hcgernhardtiii/kb-usb-to-coco/kb-usb-to-coco-pcb/kb-usb-to-coco.kicad_pcb

## KiCad design kb-usb-to-coco-pcb/kb-usb-to-coco.kicad_pcb (2025-03-23)

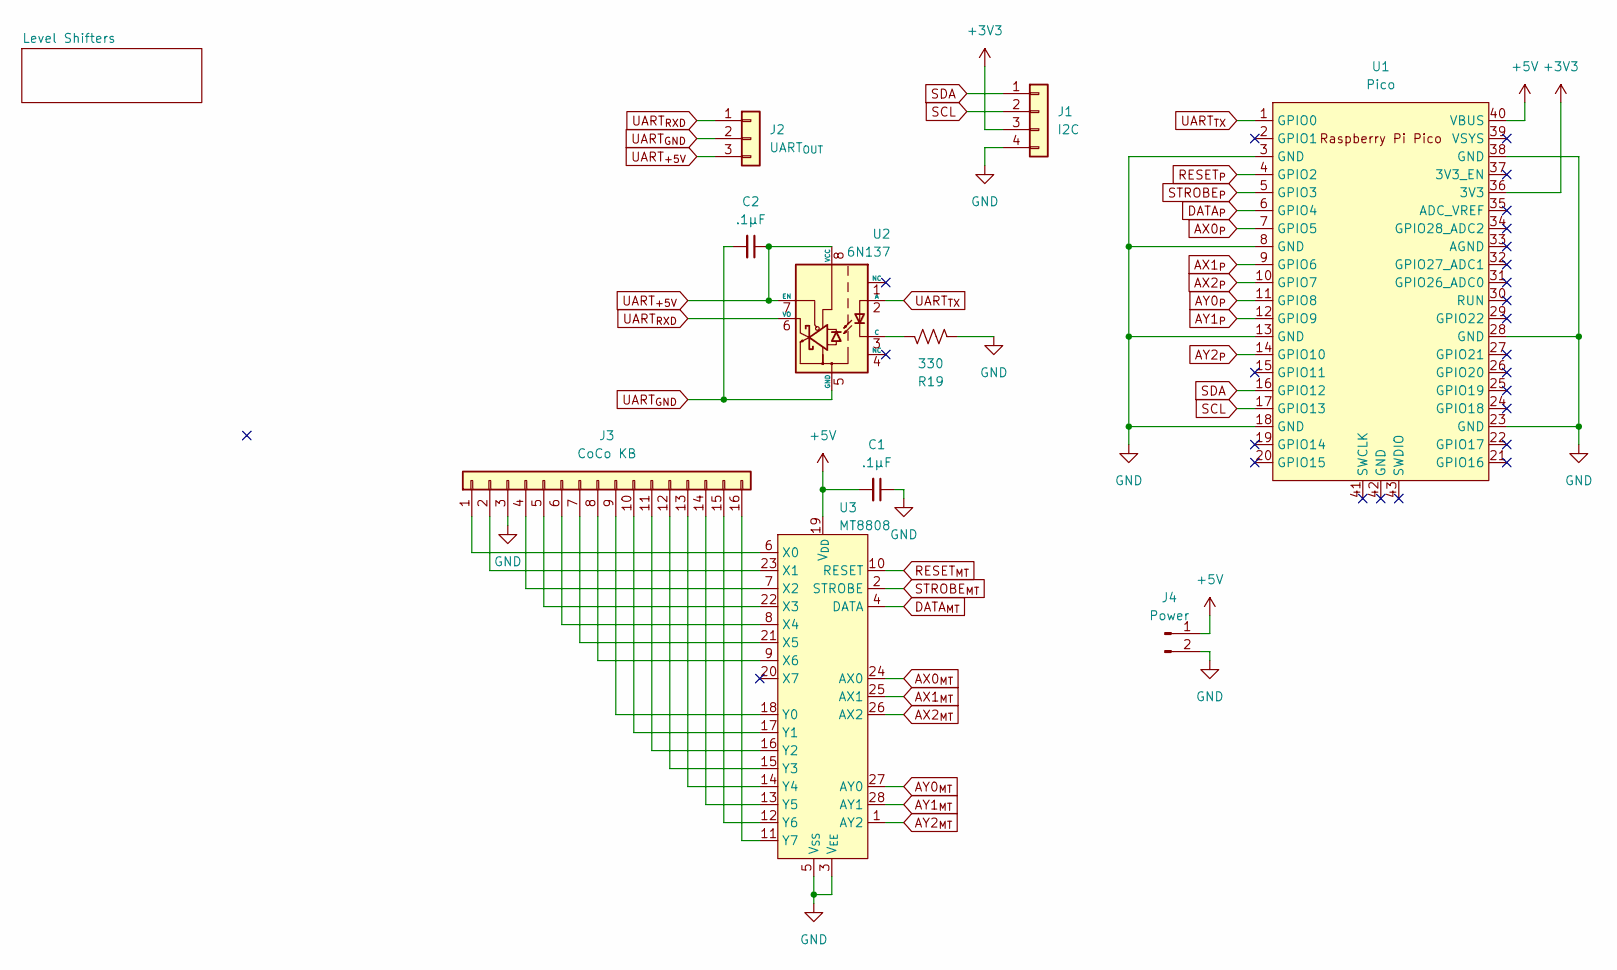
[picture p1: schematic kb-usb-to-coco.kicad_sch]

Parts:
C1, C2: .1µF; C_Disc_D6.0mm_W2.5mm_P5.00mm
J1: I2C; PinHeader_1x04_P2.54mm_Vertical
J2: UART_{OUT}; PinHeader_1x03_P2.54mm_Vertical
J3: CoCo KB; PinHeader_1x16_P2.54mm_Vertical
J4: Power; PinHeader_1x02_P2.54mm_Vertical
R19: 330; R_Axial_DIN0207_L6.3mm_D2.5mm_P7.62mm_Horizontal
U1: Pico; RPi_Pico_SMD_TH
U2: 6N137; DIP-8_W7.62mm_Socket_LongPads
U3: MT8808; DIP-28_W15.24mm_Socket_LongPads

Connections:
+3V3: J1.3, U1.36 (3V3); also elsewhere on the board
+5V: C1.2, J4.1, U1.40 (VBUS), U3.19 (V_{DD}); also elsewhere on the board
AX0_{MT}: U3.24 (AX0); also elsewhere on the board
AX0_{P}: U1.7 (GPIO5); also elsewhere on the board
AX1_{MT}: U3.25 (AX1); also elsewhere on the board
AX1_{P}: U1.9 (GPIO6); also elsewhere on the board
AX2_{MT}: U3.26 (AX2); also elsewhere on the board
AX2_{P}: U1.10 (GPIO7); also elsewhere on the board
AY0_{MT}: U3.27 (AY0); also elsewhere on the board
AY0_{P}: U1.11 (GPIO8); also elsewhere on the board
AY1_{MT}: U3.28 (AY1); also elsewhere on the board
AY1_{P}: U1.12 (GPIO9); also elsewhere on the board
AY2_{MT}: U3.1 (AY2); also elsewhere on the board
AY2_{P}: U1.14 (GPIO10); also elsewhere on the board
DATA_{MT}: U3.4 (DATA); also elsewhere on the board
DATA_{P}: U1.6 (GPIO4); also elsewhere on the board
GND: C1.1, J1.4, J3.3, J4.2, R19.1, U1.3 (GND), U1.8 (GND), U1.13 (GND), U1.18 (GND), U1.23 (GND), U1.28 (GND), U1.38 (GND), U3.3 (V_{EE}), U3.5 (V_{SS})
unnamed: J3.1, U3.6 (X0)
unnamed: J3.2, U3.23 (X1)
unnamed: J3.4, U3.7 (X2)
unnamed: J3.5, U3.22 (X3)
unnamed: J3.6, U3.8 (X4)
unnamed: J3.7, U3.21 (X5)
unnamed: J3.8, U3.9 (X6)
unnamed: J3.9, U3.18 (Y0)
unnamed: J3.10, U3.17 (Y1)
unnamed: J3.11, U3.16 (Y2)
unnamed: J3.12, U3.15 (Y3)
unnamed: J3.13, U3.14 (Y4)
unnamed: J3.14, U3.13 (Y5)
unnamed: J3.15, U3.12 (Y6)
unnamed: J3.16, U3.11 (Y7)
unnamed: R19.2, U2.3 (C)
RESET_{MT}: U3.10 (RESET); also elsewhere on the board
RESET_{P}: U1.4 (GPIO2); also elsewhere on the board
SCL: J1.2, U1.17 (GPIO13)
SDA: J1.1, U1.16 (GPIO12)
STROBE_{MT}: U3.2 (STROBE); also elsewhere on the board
STROBE_{P}: U1.5 (GPIO3); also elsewhere on the board
UART_{+5V}: C2.1, J2.3, U2.7 (EN), U2.8 (VCC)
UART_{GND}: C2.2, J2.2, U2.5 (GND)
UART_{RXD}: J2.1, U2.6 (VO)
UART_{TX}: U1.1 (GPIO0), U2.2 (A)

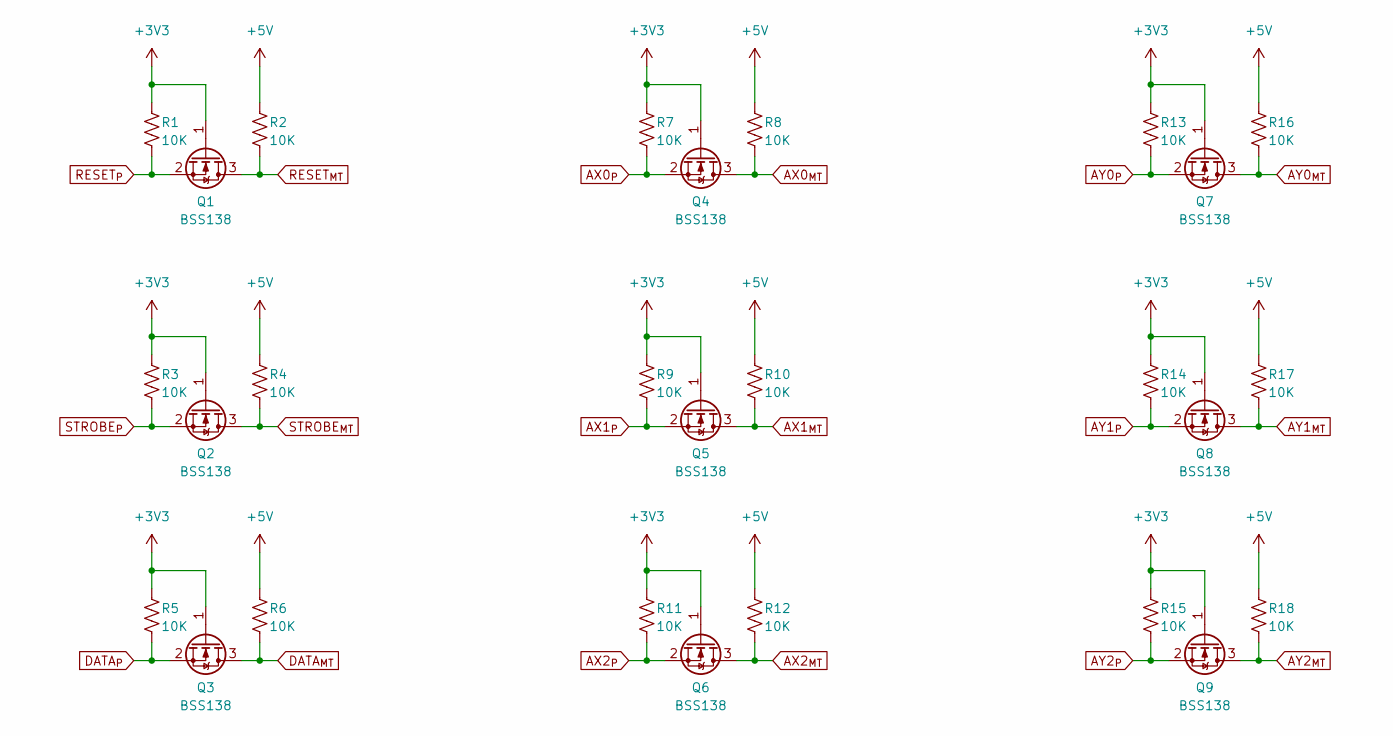
[picture p2: schematic untitled.kicad_sch]

Parts:
Q1, Q2, Q3, Q4, Q5, Q6, Q7, Q8, Q9: BSS138; SOT-23
R1, R2, R3, R4, R5, R6, R7, R8, R9, R10, R11, R12, R13, R14, R15, R16, R17, R18: 10K; R_0603_1608Metric

Connections:
+3V3: Q1.1 (G), Q2.1 (G), Q3.1 (G), Q4.1 (G), Q5.1 (G), Q6.1 (G), Q7.1 (G), Q8.1 (G), Q9.1 (G), R1.1, R3.1, R5.1, R7.1, R9.1, R11.1, R13.1, R14.1, R15.1; also elsewhere on the board
+5V: R2.1, R4.1, R6.1, R8.1, R10.1, R12.1, R16.1, R17.1, R18.1; also elsewhere on the board
AX0_{MT}: Q4.3 (D), R8.2; also elsewhere on the board
AX0_{P}: Q4.2 (S), R7.2; also elsewhere on the board
AX1_{MT}: Q5.3 (D), R10.2; also elsewhere on the board
AX1_{P}: Q5.2 (S), R9.2; also elsewhere on the board
AX2_{MT}: Q6.3 (D), R12.2; also elsewhere on the board
AX2_{P}: Q6.2 (S), R11.2; also elsewhere on the board
AY0_{MT}: Q7.3 (D), R16.2; also elsewhere on the board
AY0_{P}: Q7.2 (S), R13.2; also elsewhere on the board
AY1_{MT}: Q8.3 (D), R17.2; also elsewhere on the board
AY1_{P}: Q8.2 (S), R14.2; also elsewhere on the board
AY2_{MT}: Q9.3 (D), R18.2; also elsewhere on the board
AY2_{P}: Q9.2 (S), R15.2; also elsewhere on the board
DATA_{MT}: Q3.3 (D), R6.2; also elsewhere on the board
DATA_{P}: Q3.2 (S), R5.2; also elsewhere on the board
RESET_{MT}: Q1.3 (D), R2.2; also elsewhere on the board
RESET_{P}: Q1.2 (S), R1.2; also elsewhere on the board
STROBE_{MT}: Q2.3 (D), R4.2; also elsewhere on the board
STROBE_{P}: Q2.2 (S), R3.2; also elsewhere on the board

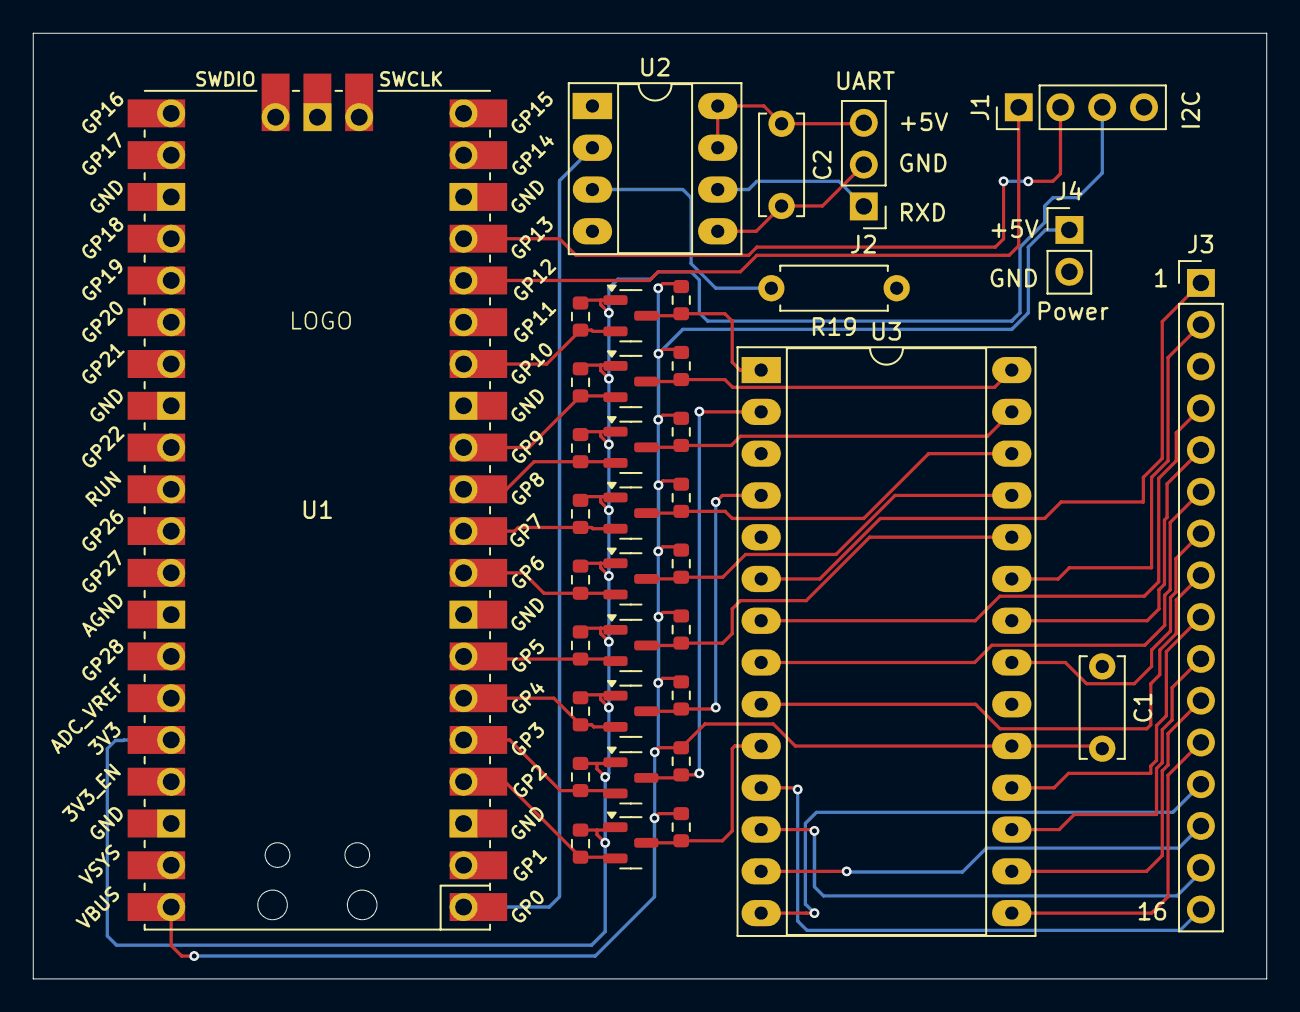
[picture p3: board kb-usb-to-coco.kicad_pcb from above]

Board: 2 copper layers, 75.0 x 57.5 mm, 38 parts (0 on the bottom side), 43 nets.

Other parts of the board:
LOGO: tbk-logo
