hcgernhardtiii/kb-usb-to-coco/kb-flat-jumper/kb-flat-jumper.kicad_pcb

## KiCad design kb-flat-jumper/kb-flat-jumper.kicad_pcb (2025-03-23)

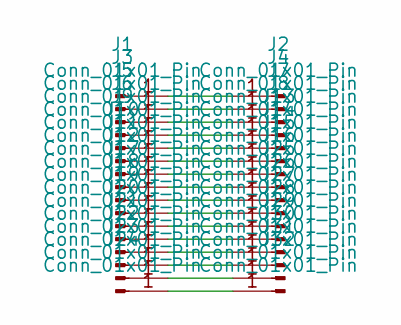
[picture p4: schematic kb-flat-jumper.kicad_sch]

Parts:
J1, J2, J3, J4, J5, J6, J7, J8, J9, J10, J11, J12, J13, J14, J15, J16, J17, J18, J19, J20, J21, J22, J23, J24, J25, J26, J27, J28, J29, J30, J31, J32: Conn_01x01_Pin; pad_1.27mm_5.588mm

Connections:
unnamed: J1.1, J2.1
unnamed: J3.1, J4.1
unnamed: J5.1, J7.1
unnamed: J6.1, J8.1
unnamed: J10.1, J14.1
unnamed: J11.1, J15.1
unnamed: J12.1, J16.1
unnamed: J9.1, J13.1
unnamed: J17.1, J25.1
unnamed: J18.1, J26.1
unnamed: J19.1, J27.1
unnamed: J20.1, J28.1
unnamed: J21.1, J29.1
unnamed: J22.1, J30.1
unnamed: J23.1, J31.1
unnamed: J24.1, J32.1

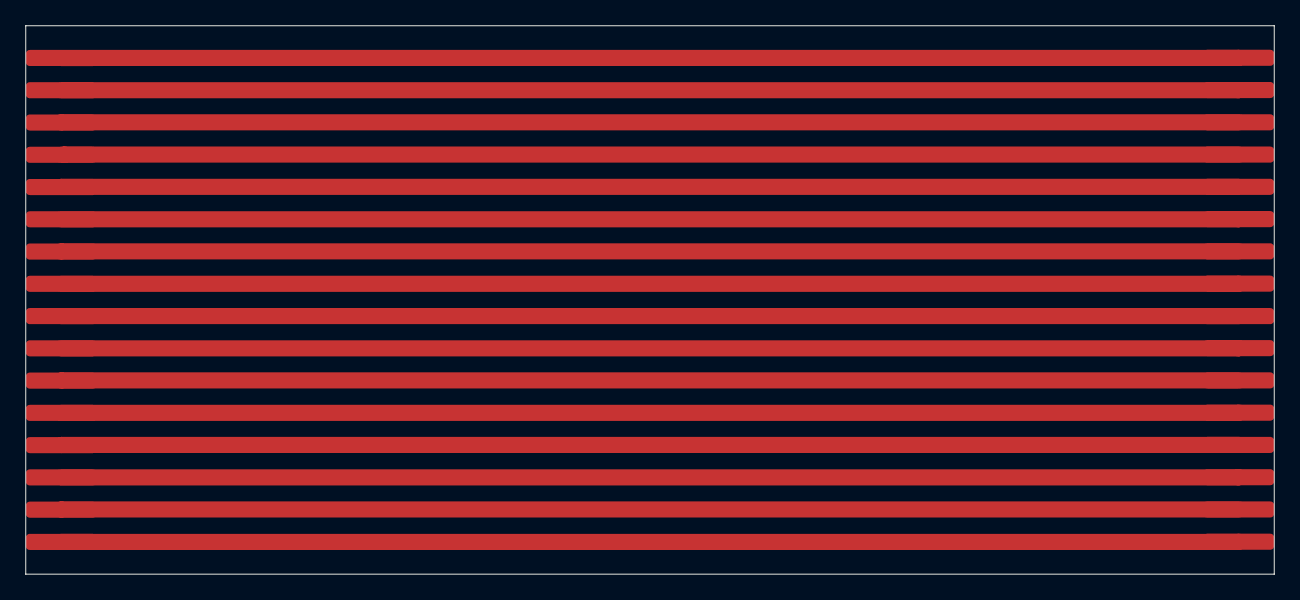
[picture p5: board kb-flat-jumper.kicad_pcb from above]

Board: 2 copper layers, 98.3 x 43.2 mm, 32 parts (0 on the bottom side), 16 nets.
