hcgernhardtiii/kb-usb-to-coco/kb-usb-to-coco-firmware/mapped_matrix.h

#ifndef ___MAPPED_MATRIX_H
#define ___MAPPED_MATRIX_H

uint8_t ecb_map[256][8][4] = {{
	{0100,0100,0100,0100},{0100,0100,0100,0100},
	{0100,0100,0100,0100},{0100,0100,0100,0100},
	{0100,0100,0100,0100},{0100,0100,0100,0100},
	{0100,0100,0100,0100},{0100,0100,0100,0100}
}, {
	{0100,0100,0100,0100},{0100,0100,0100,0100},
	{0100,0100,0100,0100},{0100,0100,0100,0100},
	{0100,0100,0100,0100},{0100,0100,0100,0100},
	{0100,0100,0100,0100},{0100,0100,0100,0100}
}, {
	{0100,0100,0100,0100},{0100,0100,0100,0100},
	{0100,0100,0100,0100},{0100,0100,0100,0100},
	{0100,0100,0100,0100},{0100,0100,0100,0100},
	{0100,0100,0100,0100},{0100,0100,0100,0100}
}, {
	{0100,0100,0100,0100},{0100,0100,0100,0100},
	{0100,0100,0100,0100},{0100,0100,0100,0100},
	{0100,0100,0100,0100},{0100,0100,0100,0100},
	{0100,0100,0100,0100},{0100,0100,0100,0100}
}, {
	{0001,0100,0100,0100},{0064,0001,0100,0100},
	{0067,0001,0100,0100},{0064,0067,0001,0100},
	{0063,0001,0100,0100},{0064,0063,0001,0100},
	{0067,0063,0001,0100},{0064,0067,0063,0001}
}, {
	{0002,0100,0100,0100},{0064,0002,0100,0100},
	{0067,0002,0100,0100},{0064,0067,0002,0100},
	{0063,0002,0100,0100},{0064,0063,0002,0100},
	{0067,0063,0002,0100},{0064,0067,0063,0002}
}, {
	{0003,0100,0100,0100},{0064,0003,0100,0100},
	{0067,0003,0100,0100},{0064,0067,0003,0100},
	{0063,0003,0100,0100},{0064,0063,0003,0100},
	{0067,0063,0003,0100},{0064,0067,0063,0003}
}, {
	{0004,0100,0100,0100},{0064,0004,0100,0100},
	{0067,0004,0100,0100},{0064,0067,0004,0100},
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
	{0100,0100,0100,0100},{0100,0100,0100,0100},
	{0100,0100,0100,0100},{0100,0100,0100,0100},
	{0100,0100,0100,0100},{0100,0100,0100,0100}
}, {
	{0100,0100,0100,0100},{0100,0100,0100,0100},
	{0100,0100,0100,0100},{0100,0100,0100,0100},
	{0100,0100,0100,0100},{0100,0100,0100,0100},
	{0100,0100,0100,0100},{0100,0100,0100,0100}
}, {
	{0100,0100,0100,0100},{0100,0100,0100,0100},
	{0100,0100,0100,0100},{0100,0100,0100,0100},
	{0100,0100,0100,0100},{0100,0100,0100,0100},
	{0100,0100,0100,0100},{0100,0100,0100,0100}
}, {
	{0100,0100,0100,0100},{0100,0100,0100,0100},
	{0100,0100,0100,0100},{0100,0100,0100,0100},
	{0100,0100,0100,0100},{0100,0100,0100,0100},
	{0100,0100,0100,0100},{0100,0100,0100,0100}
}, {
	{0100,0100,0100,0100},{0100,0100,0100,0100},
	{0100,0100,0100,0100},{0100,0100,0100,0100},
	{0100,0100,0100,0100},{0100,0100,0100,0100},
	{0100,0100,0100,0100},{0100,0100,0100,0100}
}, {
	{0100,0100,0100,0100},{0100,0100,0100,0100},
	{0100,0100,0100,0100},{0100,0100,0100,0100},
	{0100,0100,0100,0100},{0100,0100,0100,0100},
	{0100,0100,0100,0100},{0100,0100,0100,0100}
}};

#endif
