hcgernhardtiii/kb-usb-to-coco/kb-usb-to-coco-firmware/kb-usb-to-coco-firmware.h

#ifndef ___KB_USB_TO_COCO_FIRMWARE_H
#define ___KB_USB_TO_COCO_FIRMWARE_H

#include <stdio.h>
#include "time.h"
#include "pico/stdlib.h"
#include "hardware/gpio.h"
#include "bsp/board_api.h"
#include "tusb.h"
#include "mt8808.h"
#include "raw_matrix.h"
#include "mapped_matrix.h"
#include "ssd1306_i2c.h"
#include "sprite.h"

#define MAX_REPORT 4

static struct {
	uint8_t report_count;
	tuh_hid_report_info_t report_info[MAX_REPORT];
} hid_info[CFG_TUH_HID];

static uint8_t blank_screen[128*8];
static struct render_area blank_screen_area = {
	.start_col = 0,
	.end_col = 127,
	.start_page = 0,
	.end_page = 7,
	.buflen = 128 * 8
};

static bool screen_is_dirty = false;

// Some mode flags we'll need:
// - <kbd>GUI</kbd> is our special function key.  If it's pressed we're talking
//   to the interface, not to the CoCo.
static bool gui_is_pressed = false;
// - Whether or not we're in mapped mode (we start in raw mode)
static bool mapped_mode_active = false;
// - Whether or not we're recording a macro (macro keys will be dealt with in
//   `process_kbd_report()`)
static bool recording_macro = false;

// Whether or not a keycode exists within a given matrix
#define MATRIX_HAS(mtx, key) ( \
	!!(((mtx)[((key) & 0xf0) >> 4]) & (1 << ((key) & 0x0f))) \
)

void led_blinking_task (void);
static void process_kbd_report(hid_keyboard_report_t const *report);
static void cls();
static void putblock (int row, int col);
static void clrblock (int row, int col);
static inline void mt8808_send (int row, int col, int data);
static inline void macro_record_send (int row, int col, int data) {}
static inline void mt8808_pause();
static inline void macro_record_pause() {}

// process the matrix in raw mode
static void raw_mode (hid_keyboard_report_t const *report);
// process the matrix in mapped mode
static void mapped_mode (
	hid_keyboard_report_t const *report,
	uint16_t presses[16]
);

// Visualize the “big” matrix—the raw keyboard scan itself
static void visualize_bigm (
	uint16_t cur[16],
	uint16_t presses[16],
	uint16_t releases[16]
);

#endif
