hcgernhardtiii/kb-usb-to-coco/kb-usb-to-coco-firmware/sprite.h

#include "ssd1306_i2c.h"

// two-quote and at sign are 35+6+12
struct render_area two_quote_area = {
	.start_col = (127 - (35 + 6 + 12)) / 2,
	.end_col = ((127 - (35 + 6 + 12)) / 2) + 11,
	.start_page = 2,
	.end_page = 7,
	.buflen = 12 * 6
};
uint8_t two_quote_buf[12*6] = {
	0x80, 0x80, 0x80, 0x80, 0x80, 0x00, 0x00, 0x80, 0x80, 0x80, 0x80, 0x80, 
	0x0f, 0x7f, 0x7f, 0x7f, 0x0f, 0x00, 0x00, 0x0f, 0x7f, 0x7f, 0x7f, 0x0f,
	0x00, 0x00, 0x00, 0x80, 0x80, 0x80, 0x80, 0x80, 0x80, 0x00, 0x00, 0x00,
	0x1c, 0x1e, 0x1f, 0x1f, 0x07, 0x03, 0x03, 0x87, 0xff, 0xff, 0xfe, 0x7c,
	0xc0, 0xe0, 0xf0, 0xf8, 0xfc, 0xde, 0xcf, 0xc7, 0xc3, 0xc3, 0xc1, 0xc0,
	0x01, 0x01, 0x01, 0x01, 0x01, 0x01, 0x01, 0x01, 0x01, 0x01, 0x01, 0x01
};

struct render_area at_area = {
	.start_col = ((127 - (35 + 6 + 12)) / 2) + 12 + 6,
	.end_col = ((127 - (35 + 6 + 12)) / 2) + 12 + 6 + 34,
	.start_page = 2,
	.end_page = 7,
	.buflen = 35 * 6
};
uint8_t at_buf[35*6] = {
	0x00, 0x00, 0x00, 0x00, 0x00, 0x00, 0x00, 0x00, 0x00, 0x00, 0x00, 0x00, 0x00, 0x00, 0x00, 0x80, 0x80, 0x80, 0x80, 0x80, 0x80, 0x80, 0x80, 0x80, 0x00, 0x00, 0x00, 0x00, 0x00, 0x00, 0x00, 0x00, 0x00, 0x00, 0x00,
	0x00, 0x00, 0x00, 0x80, 0xc0, 0xe0, 0xf0, 0xf8, 0x7c, 0x3c, 0x1e, 0x0e, 0x0f, 0x07, 0x07, 0x03, 0x83, 0x83, 0x83, 0x83, 0x83, 0x03, 0x03, 0x07, 0x87, 0x8f, 0x8f, 0x1e, 0x3e, 0x7c, 0xf8, 0xf0, 0xe0, 0x80, 0x00,
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
	0xff, 0xff, 0xff, 0xff, 0xff, 0xff, 0x03, 0x03, 0x03,
	0xff, 0xff, 0xff, 0xff, 0xff, 0xff, 0x00, 0x00, 0x00,
	0xff, 0xff, 0xff, 0xff, 0xff, 0xff, 0x00, 0x00, 0x00,
	0xff, 0xff, 0xff, 0xff, 0xff, 0xff, 0xc0, 0xc0, 0xc0,
	0x03, 0x03, 0x03, 0x03, 0x03, 0x03, 0x03, 0x03, 0x03
};
