hcgernhardtiii/kb-usb-to-coco/(commit log)

2025-03-23 Hardware for CoCo only is complete Firmware is currently set up for direct only
2025-03-23 Added all the things I talked about in the last commit message
    [kb-flat-jumper-B_Cu.gbr, kb-flat-jumper-B_Mask.gbr, kb-flat-jumper-B_Paste.gbr, kb-flat-jumper-B_Silkscreen.gbr, kb-flat-jumper-Edge_Cuts.gbr, kb-flat-jumper-F_Cu.gbr, kb-flat-jumper-F_Mask.gbr, kb-flat-jumper-F_Paste.gbr]
2025-03-23 Added branch for video creation. Commit made after each stage.
2025-03-28 Episode 4: Commit 5: Make sure the mode switch works (<kbd>GUI</kbd>+<kbd>Z</kbd>
